TiansuWang/WatchTower-Beacon-Project/ReadMe.md

This project is the work done by Tiansu Wang During the internship in WatchTower Robotics(https://www.wtrco.com).

#
