TiansuWang/WatchTower-Beacon-Project/beacon code/second version of beacon/wireless assign ID/read me.pdf

There are three set of code:

1. code_in_node3.1_node1
should be downloaded into the sensor nodes a head of time(no need to alter anything in the code.) the initial ID of each sensor node id 255.

Sensor node hardware requirement:
400Mhz radio chip
900Mhz radio chip
GPS
2. computer_side2.2
should be download into the computer side node, which connected to the computer. It will print received data from sensor nodes into the processing code in specific format.

Computer node hardware requirement:
900Mhz radio chip
3. configure_node
configure node is a node that should connected to laptop and carry with you during the deployment of sensor nodes. Can assign node_ID to the sensor nodes and exam connections between nodes.

Configure node hardware requirement:
400Mhz radio chip
900Mhz radio chip
configure node should not wear antennas and should be placed really close to the node that your are going to configure.(like within 5 cm).

Operating Instruction:

Enter “NODE_ID,DEST_ID.” and press enter to configure the sensor node. Just like:

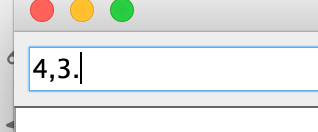
[picture p1: figure]

Assign the node_ID = 4, and unicast to 3.

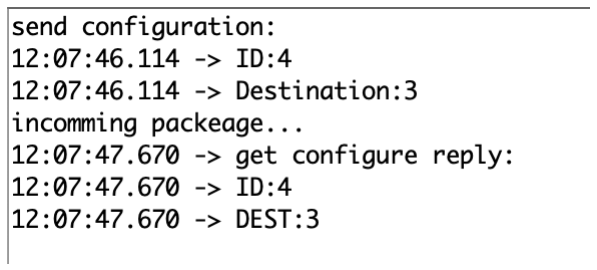
[picture p2: figure]

When you get configure reply that means configuration success,(should get replay with in 2 seconds) otherwise configuration node is not close enough to the sensor node you are trying to assign id.

Then press ‘e’ into the serial monitor.

And ‘send echo’ appear in the serial monitor. After 3 seconds you should have a incoming package to tell you weather the echo is a success, otherwise configure node is not communicating with the sensor node.

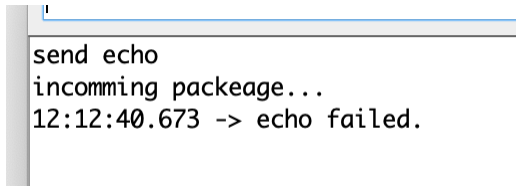
[picture p3: figure]

Here is a success echo:

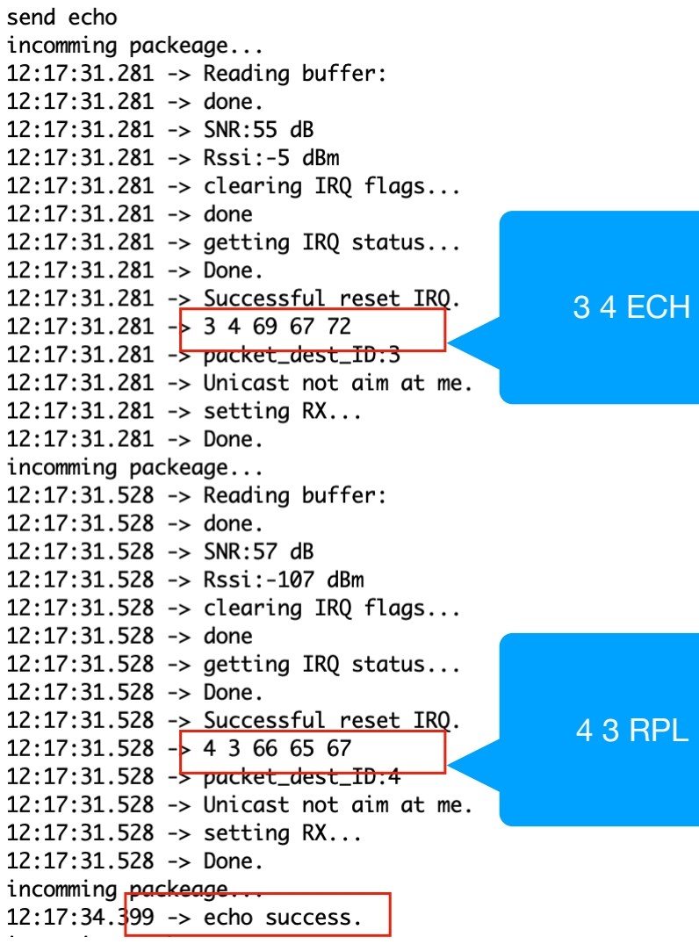
[picture p4: figure]
3 4 ECH; 4 3 RPL
