TiansuWang/WatchTower-Beacon-Project/system diagram/operational chart/deplyment.pdf

# On deployment

1.

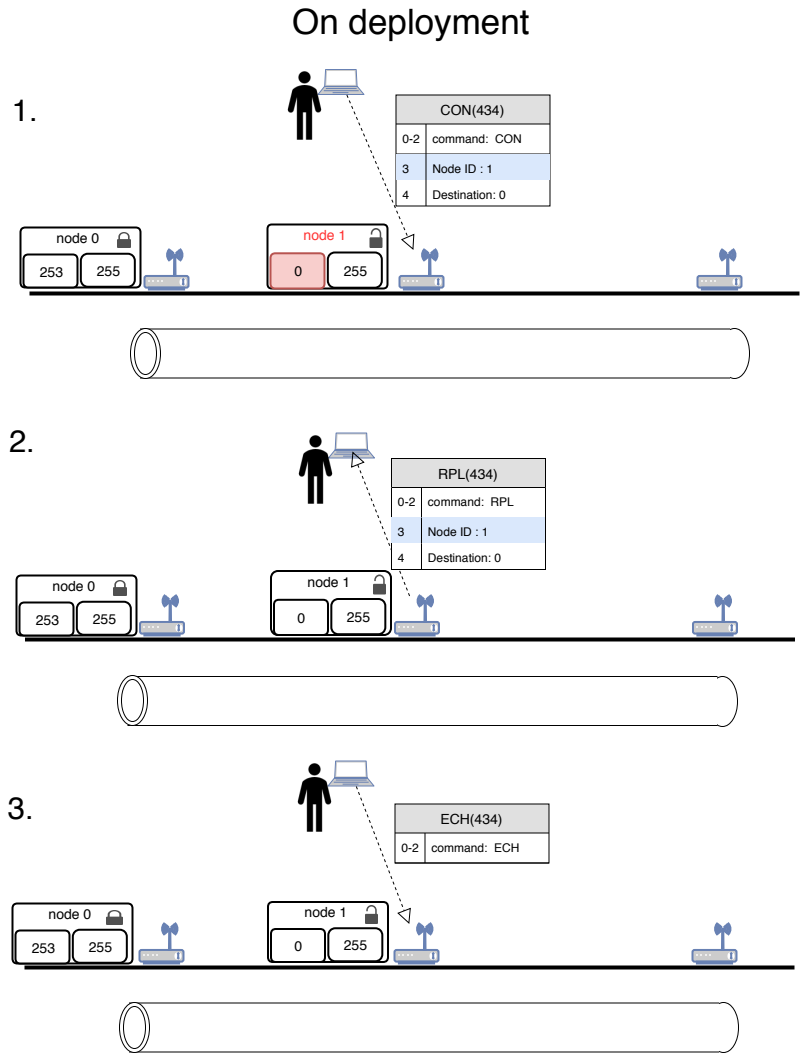
[picture p5: page 1]
node 0; node 1; CON(434); command: CON; Node ID : 1; Destination: 0; RPL(434); command: RPL; ECH(434); command: ECH

4.

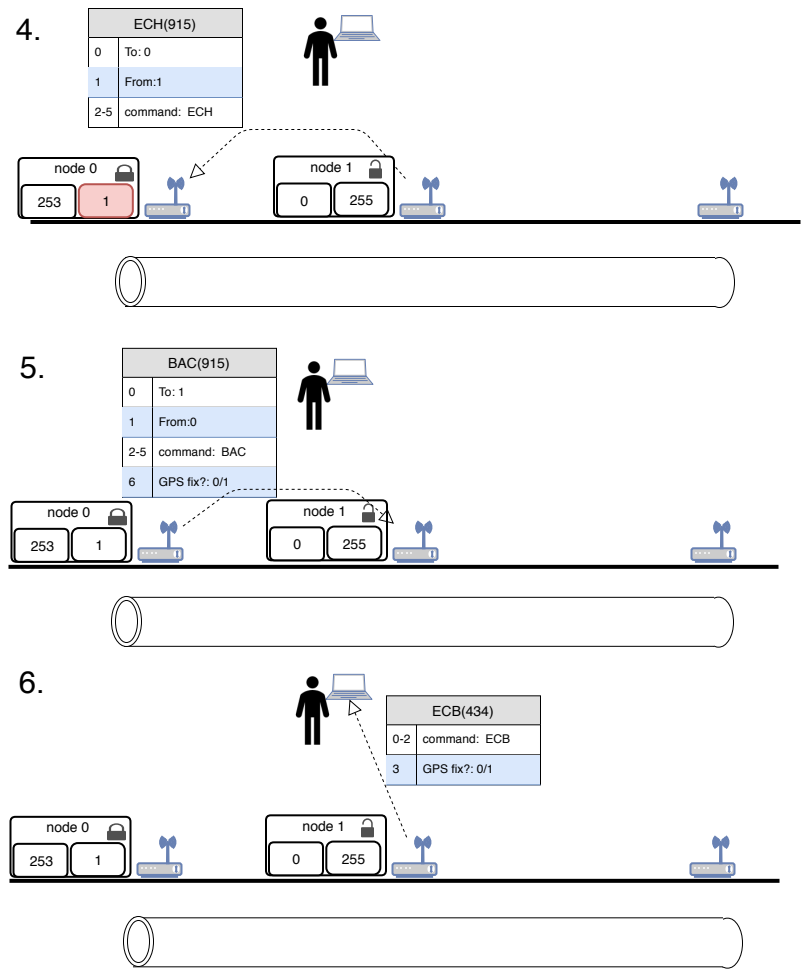
[picture p6: page 2]
node 0; node 1; ECH(915); From:1; command: ECH; BAC(915); From:0; command: BAC; GPS fix?: 0/1; ECB(434); command: ECB

7.

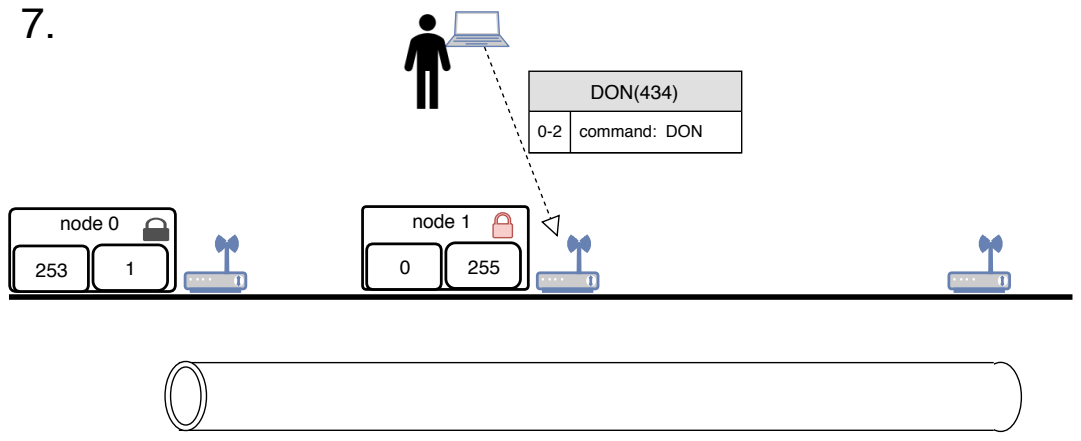
[picture p7: page 3]
node 0; node 1; DON(434); command: DON
