TiansuWang/WatchTower-Beacon-Project/circuit diagam/version 1&2 beacon circuit/pcb2_board/Eagle_Schematics and Board Files/PCB2_SHIELD.brd

## EAGLE design circuit diagam/version 1&2 beacon circuit/pcb2_board/Eagle_Schematics and Board Files/PCB2_SHIELD.brd (2019-07-08)

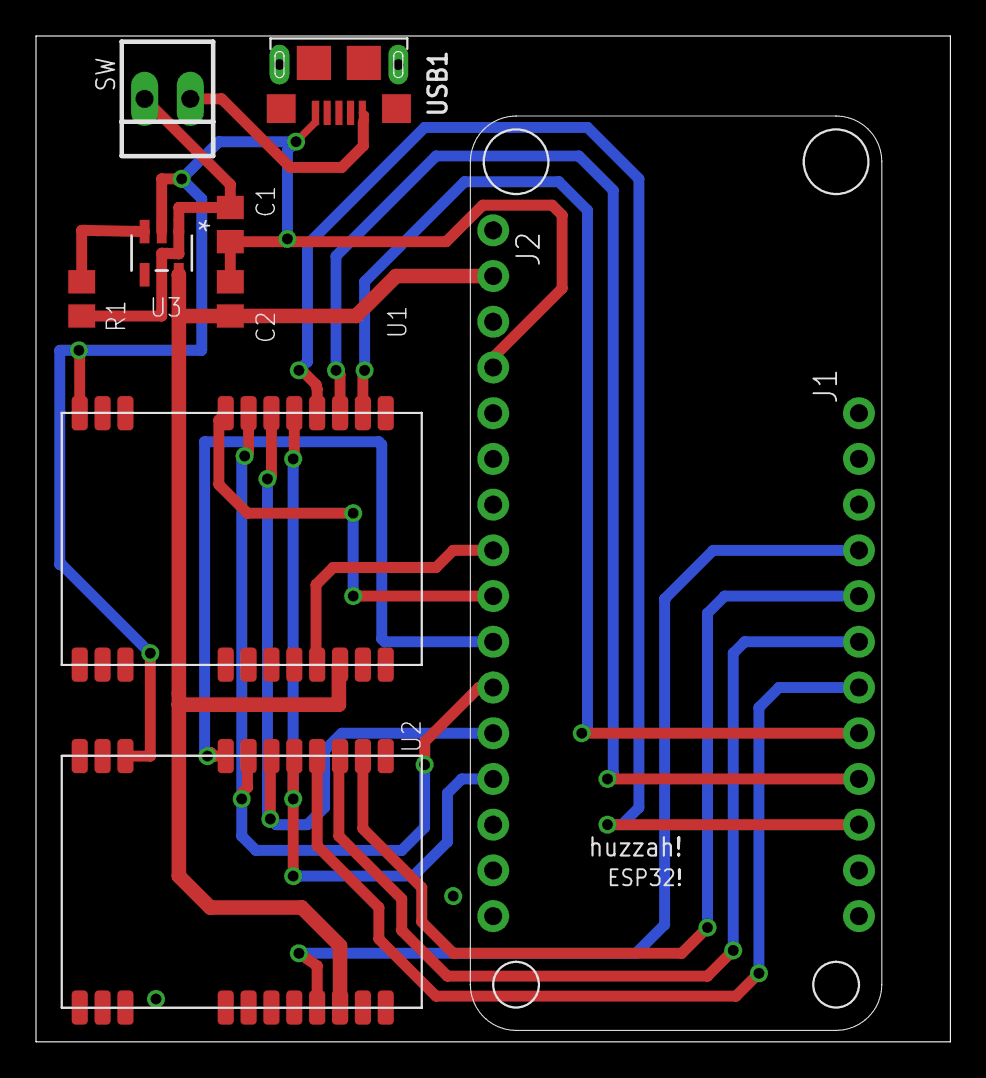
[picture p8: board PCB2_SHIELD.brd from above]

Board: 2 copper layers, 50.8 x 55.9 mm, 9 parts (0 on the bottom side), 17 nets.

Parts:
C1, C2: C0805
MS1: FEATHERWING
R1: R0805
SW: 22-23-2021
U1: E22-900M22S; E22
U2: E22-400M22S; E22
U3: AP2112; SOT25
USB1: USB; 10118193-0001LF

Connections:
GND: C1.2, C2.2, MS1.4, U1.1, U1.2, U1.3, U1.4, U1.5, U1.10, U1.11, U1.12, U1.20, U1.22, U2.1, U2.2, U2.3, U2.4, U2.5, U2.10, U2.11, U2.12, U2.20, U2.22, U3.2, USB1.GND
unnamed: MS1.9, U1.19
unnamed: MS1.11, U1.18, U2.18
unnamed: MS1.12, U1.17, U2.17
unnamed: MS1.13, U1.16, U2.16
unnamed: MS1.19, U1.15
unnamed: MS1.20, U1.14
unnamed: MS1.21, U1.13
unnamed: MS1.8, U1.8
unnamed: MS1.25, U2.8
unnamed: MS1.24, U2.13
unnamed: MS1.23, U2.14
unnamed: MS1.22, U2.15
unnamed: MS1.10, U2.19
unnamed: C1.1, R1.1, SW.2, U3.1
unnamed: R1.2, SW.1, U3.3, USB1.VBUS
VCC: C2.1, MS1.2, U1.9, U2.9, U3.5
