TiansuWang/WatchTower-Beacon-Project/circuit diagam/version 3 beacon circuit/pcb3/Eagle Files/PCB3.brd

## EAGLE design circuit diagam/version 3 beacon circuit/pcb3/Eagle Files/PCB3.brd (2019-07-08)

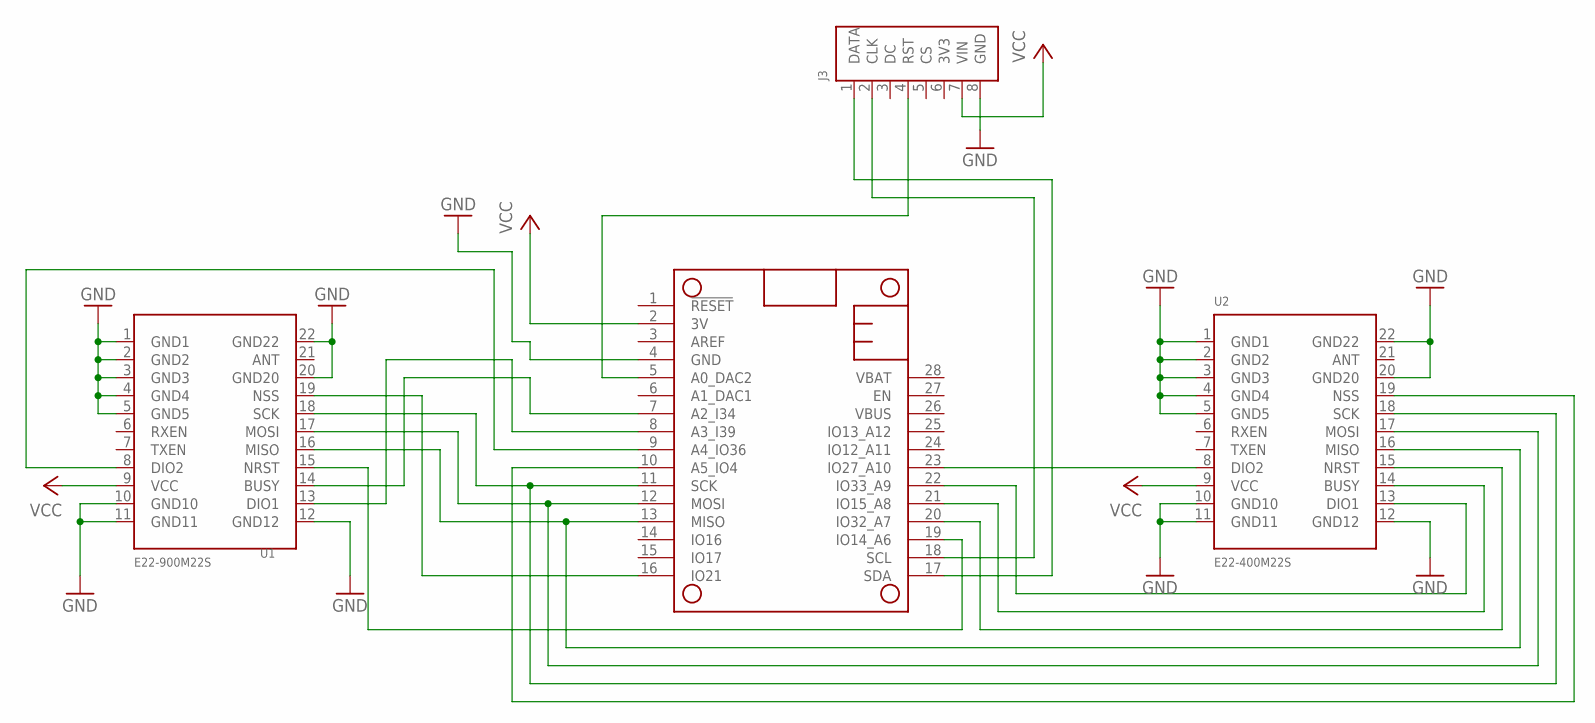
[picture p9: schematic PCB3.sch]

Parts:
J3: 1.3"_128X64; 1.3"_128X64_OLED
MS1: FEATHERWING
U1: E22-900M22S; E22
U2: E22-400M22S; E22

Connections:
3V3: J3.6 (3V3)
400BUSY: MS1.21 (IO15_A8), U2.14 (BUSY)
400CS: MS1.10 (A5_IO4), U2.19 (NSS)
400NRESET: MS1.20 (IO32_A7), U2.15 (NRST)
400RXINT: MS1.22 (IO33_A9), U2.13 (DIO1)
400TXINT: MS1.23 (IO27_A10), U2.8 (DIO2)
900BUSY: MS1.7 (A2_I34), U1.14 (BUSY)
900CS: MS1.16 (IO21), U1.19 (NSS)
900RXINT: MS1.8 (A3_I39), U1.13 (DIO1)
900TXINT: MS1.9 (A4_IO36), U1.8 (DIO2)
GND: J3.8 (GND), MS1.4 (GND), U1.1 (GND1), U1.2 (GND2), U1.3 (GND3), U1.4 (GND4), U1.5 (GND5), U1.10 (GND10), U1.11 (GND11), U1.12 (GND12), U1.20 (GND20), U1.22 (GND22), U2.1 (GND1), U2.2 (GND2), U2.3 (GND3), U2.4 (GND4), U2.5 (GND5), U2.10 (GND10), U2.11 (GND11), U2.12 (GND12), U2.20 (GND20), U2.22 (GND22)
MISO: MS1.13 (MISO), U1.16 (MISO), U2.16 (MISO)
MOSI: MS1.12 (MOSI), U1.17 (MOSI), U2.17 (MOSI)
unnamed: J3.2 (CLK), MS1.18 (SCL)
unnamed: J3.1 (DATA), MS1.17 (SDA)
unnamed: MS1.19 (IO14_A6), U1.15 (NRST)
RST: J3.4 (RST), MS1.5 (A0_DAC2)
SCK: MS1.11 (SCK), U1.18 (SCK), U2.18 (SCK)
VCC: J3.7 (VIN), MS1.2 (3V), U1.9 (VCC), U2.9 (VCC)

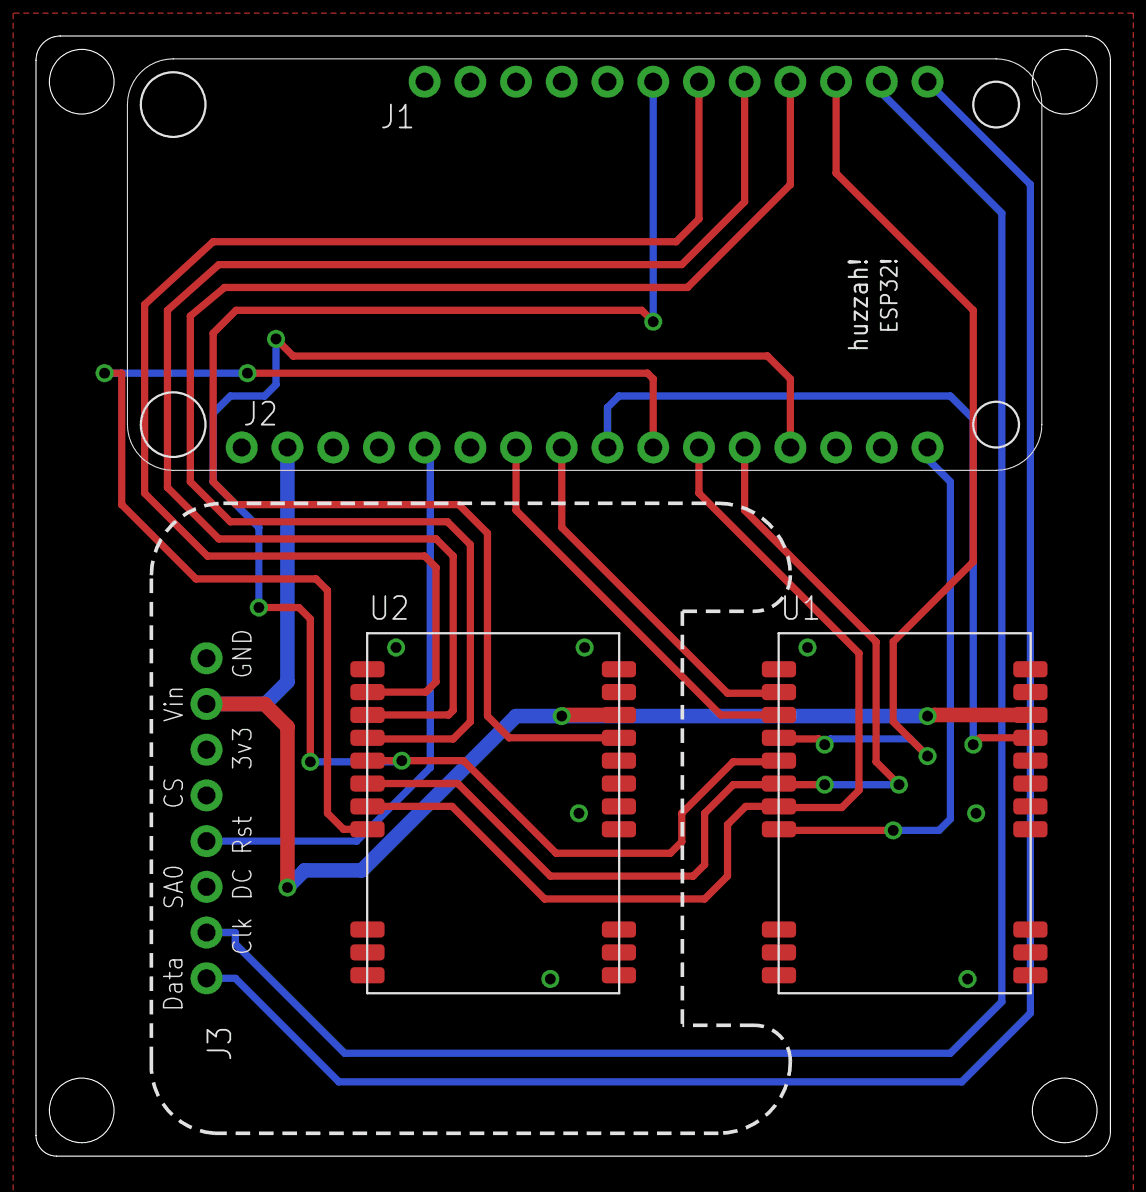
[picture p10: board PCB3.brd from above]

Board: 2 copper layers, 59.7 x 62.2 mm, 4 parts (0 on the bottom side), 18 nets.
